BioARTS-Lab/Hybrid-Opto-Thermocycler-for-RT-qPCR-detects-SARS-CoV-2-/README.md

# Hybrid-Opto-Thermocycler-for-RT-qPCR-detects-SARS-CoV-2-
Supporting Information
