BioARTS-Lab/Hybrid-Opto-Thermocycler-for-RT-qPCR-detects-SARS-CoV-2-/Light PCB.png

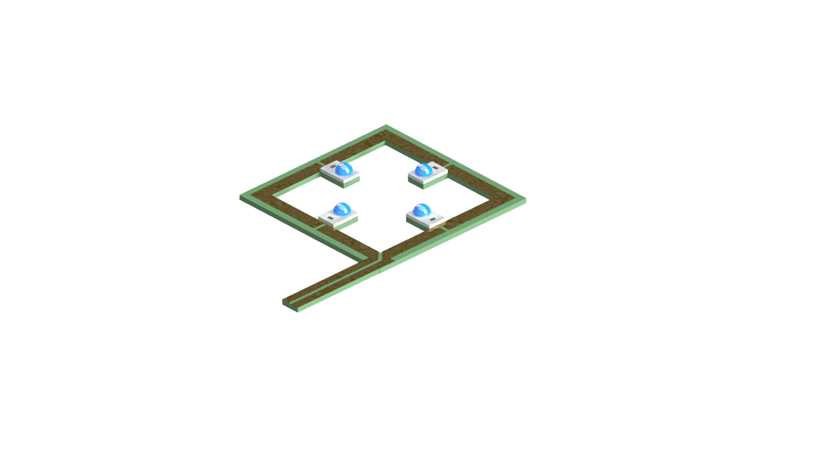
Light PCB.png
