BioARTS-Lab/Hybrid-Opto-Thermocycler-for-RT-qPCR-detects-SARS-CoV-2-/PCBs.png

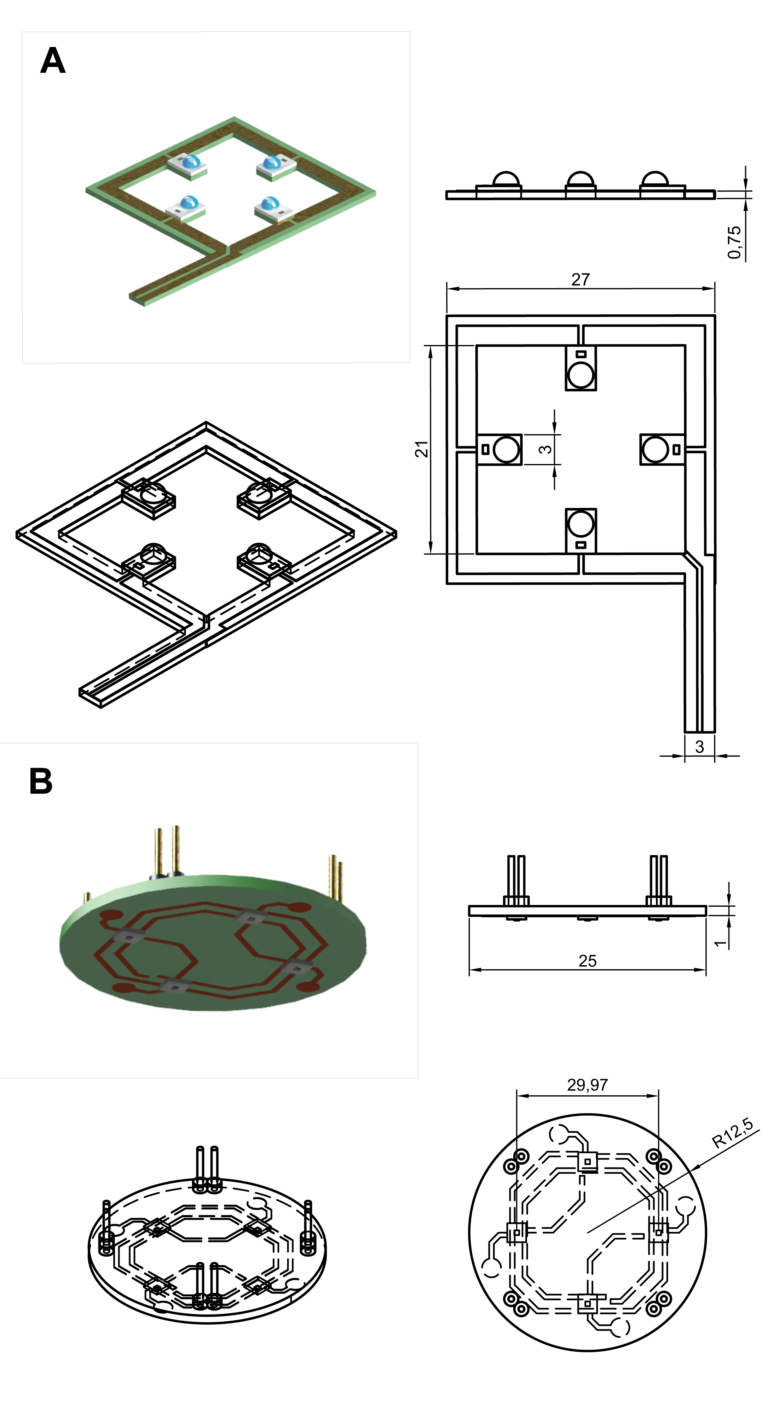
PCBs.png
