BioARTS-Lab/Hybrid-Opto-Thermocycler-for-RT-qPCR-detects-SARS-CoV-2-/Sensor PCB.png

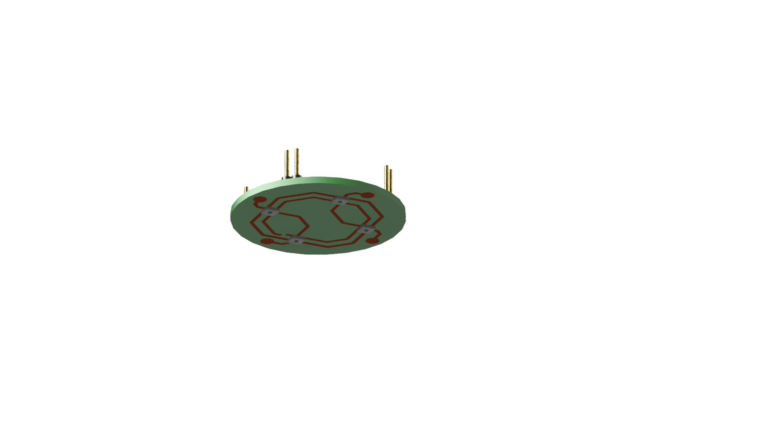
Sensor PCB.png
