BioARTS-Lab/Hybrid-Opto-Thermocycler-for-RT-qPCR-detects-SARS-CoV-2-/Aluminum piece.pdf

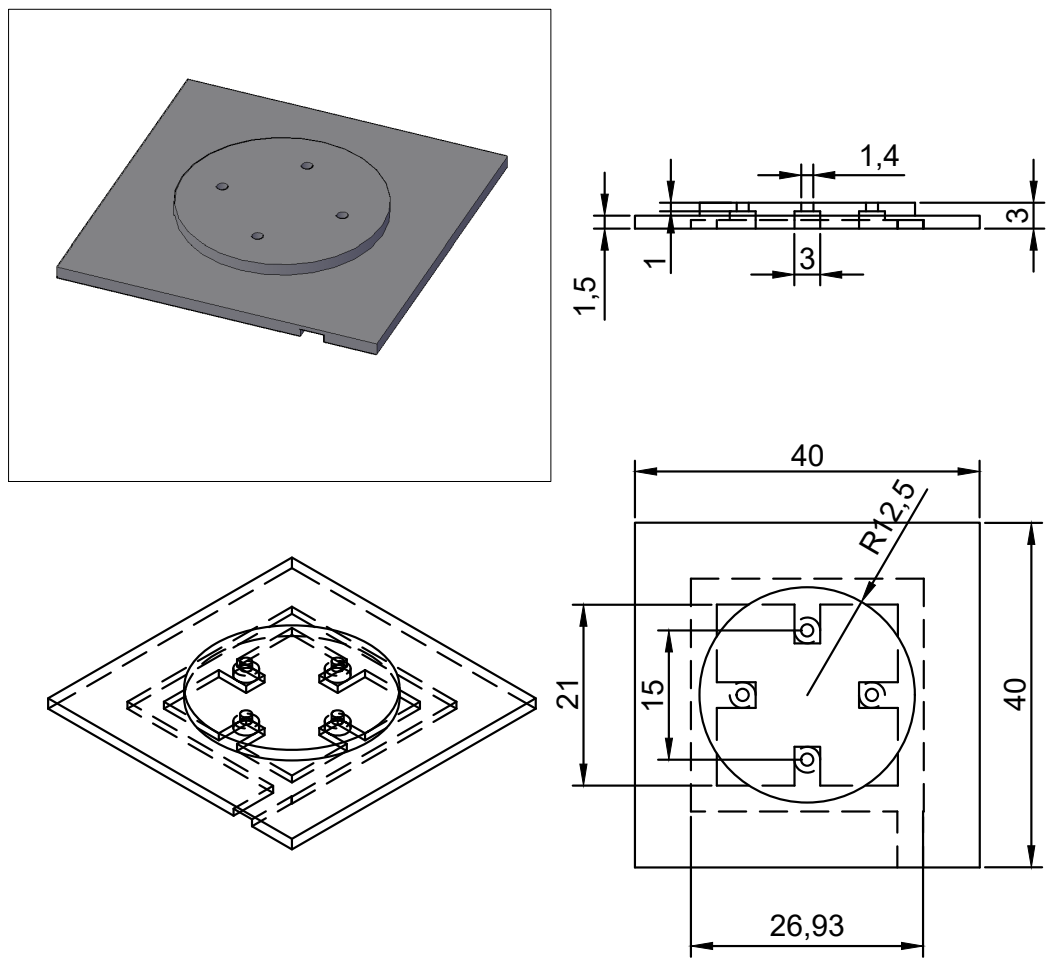
[picture p15: page 1]
