BioARTS-Lab/Hybrid-Opto-Thermocycler-for-RT-qPCR-detects-SARS-CoV-2-/Chip aligner.pdf

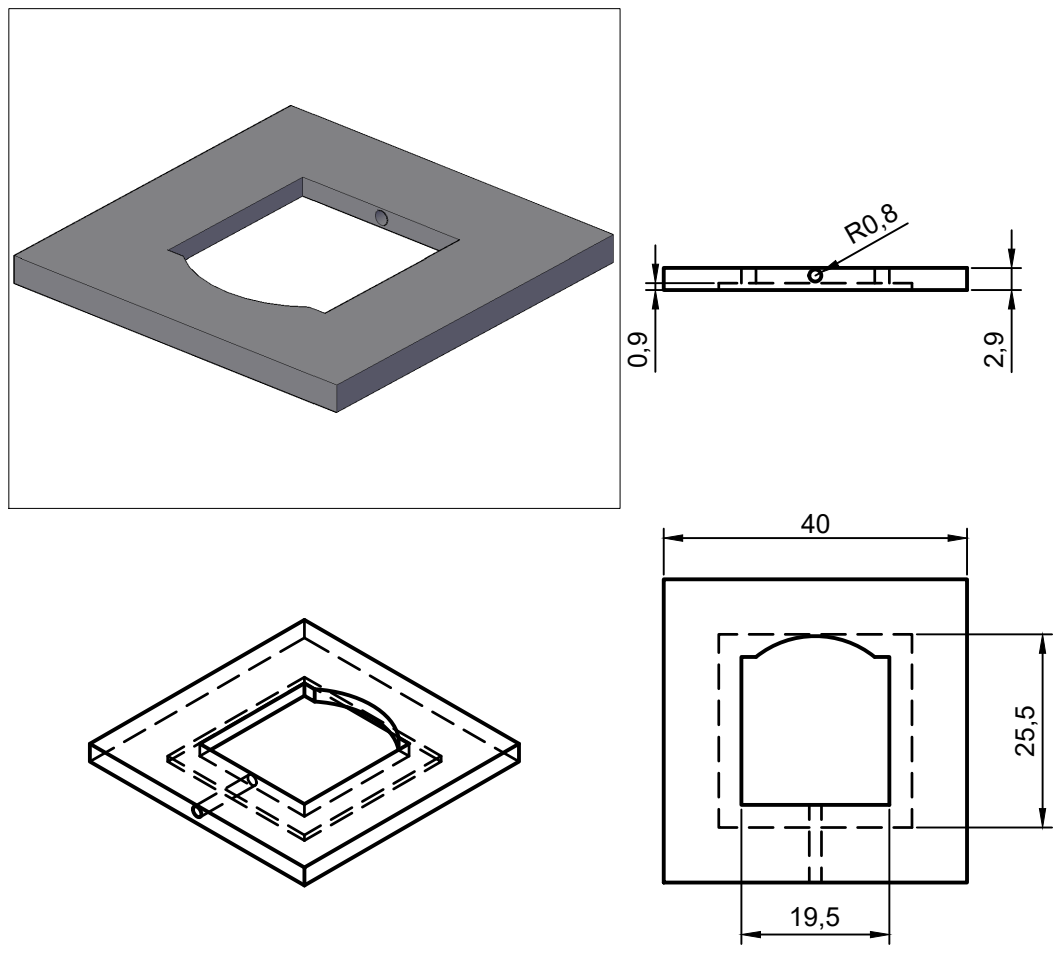
[picture p16: page 1]
