BioARTS-Lab/Hybrid-Opto-Thermocycler-for-RT-qPCR-detects-SARS-CoV-2-/Sensor PCB.pdf

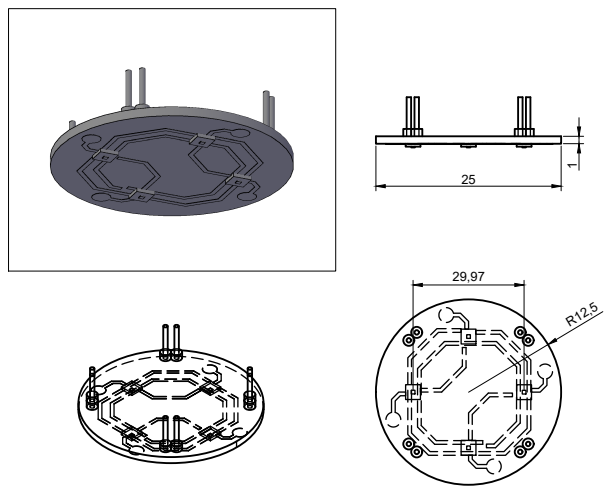
[picture p22: page 1]
